jarsoftelectrical/PLUS/STL files/Pictures/20170216_212925.jpg

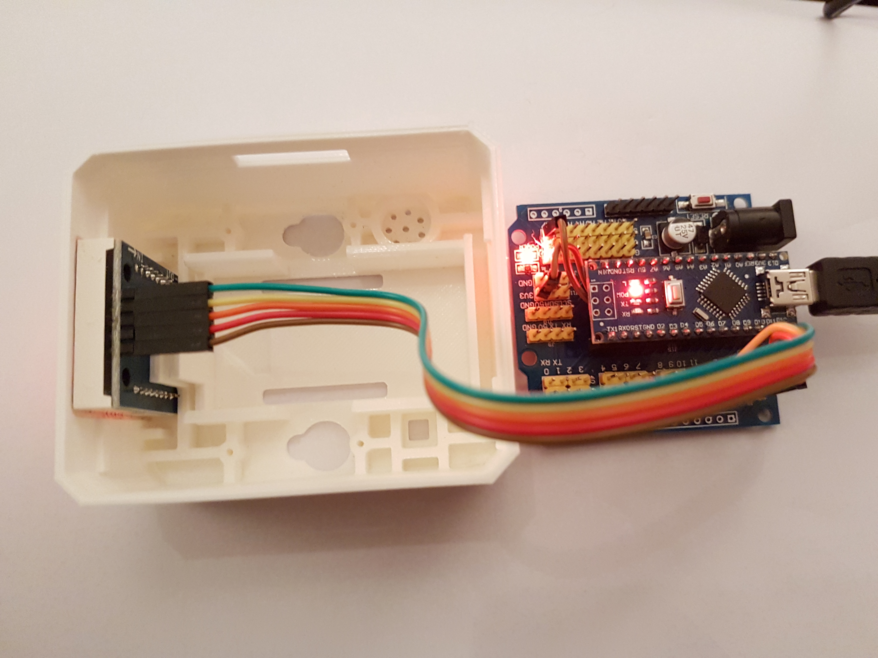
STL files/Pictures/20170216_212925.jpg
