jarsoftelectrical/PLUS/STL files/Pictures/20170216_213122.jpg

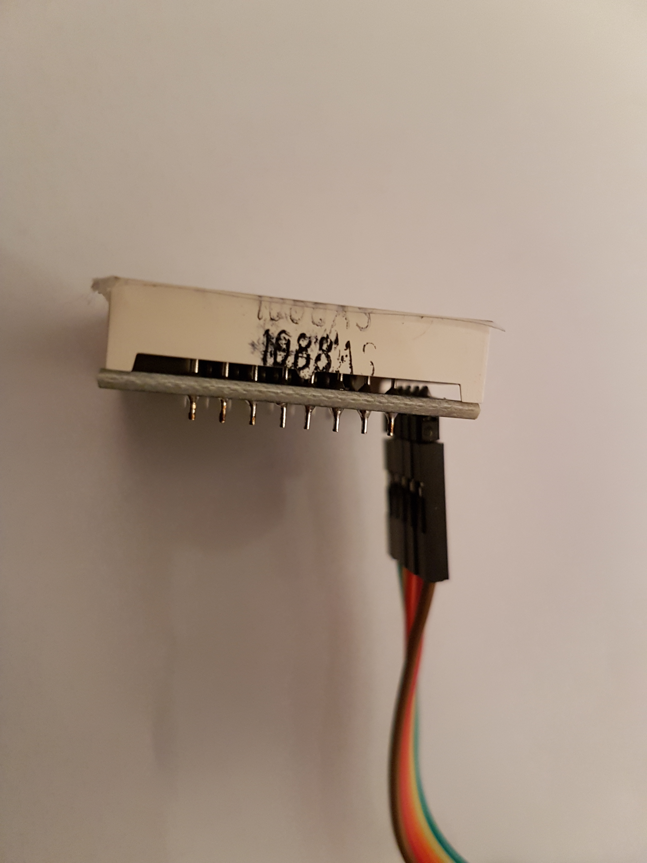
STL files/Pictures/20170216_213122.jpg
