jarsoftelectrical/PLUS/README.md

# PLUS
"Otto DIY with steroids" + Bluetooth + APP + switch + sensors + strength +...
