jarsoftelectrical/PLUS/OTTO-PCB/OTTO PCB ver2.png

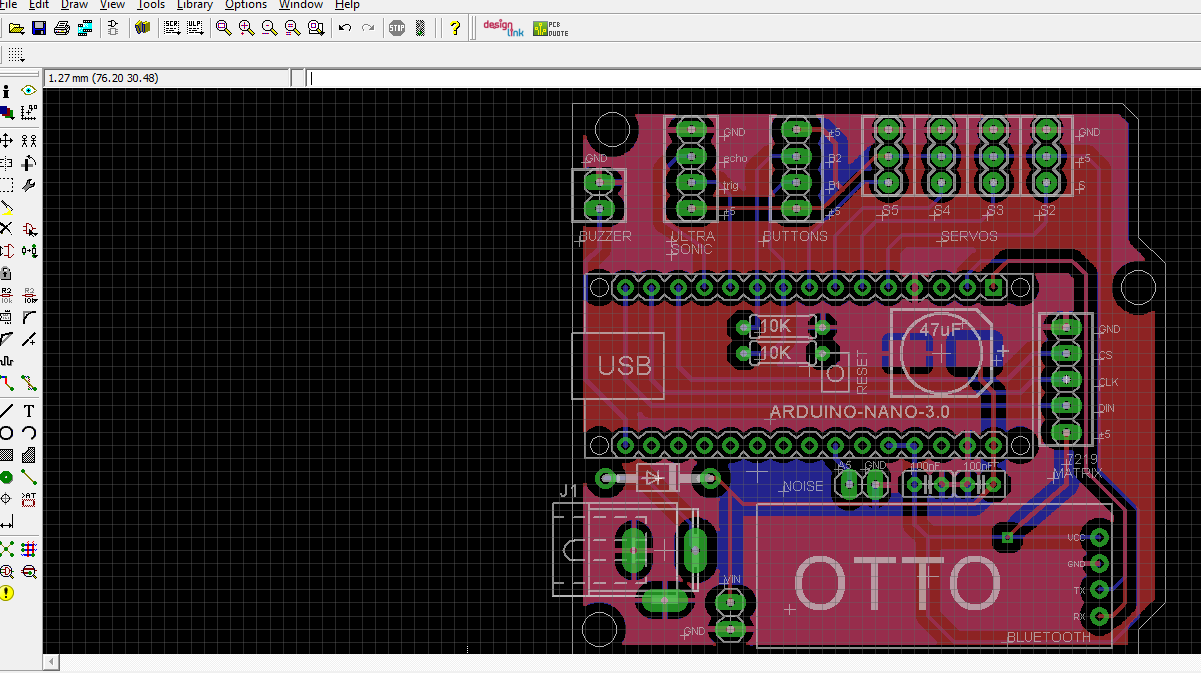
OTTO-PCB/OTTO PCB ver2.png
