jarsoftelectrical/PLUS/STL files/Pictures/20170216_222948.jpg

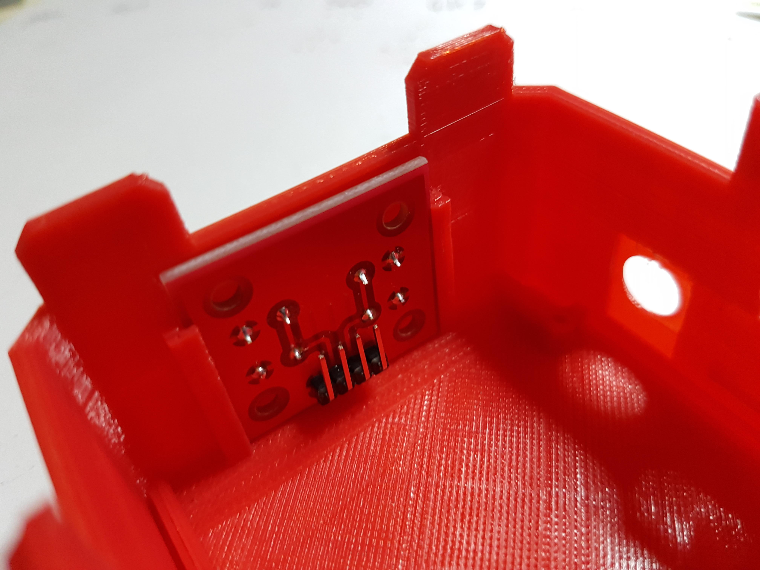
STL files/Pictures/20170216_222948.jpg
