jarsoftelectrical/PLUS/STL files/Pictures/20170217_212710.jpg

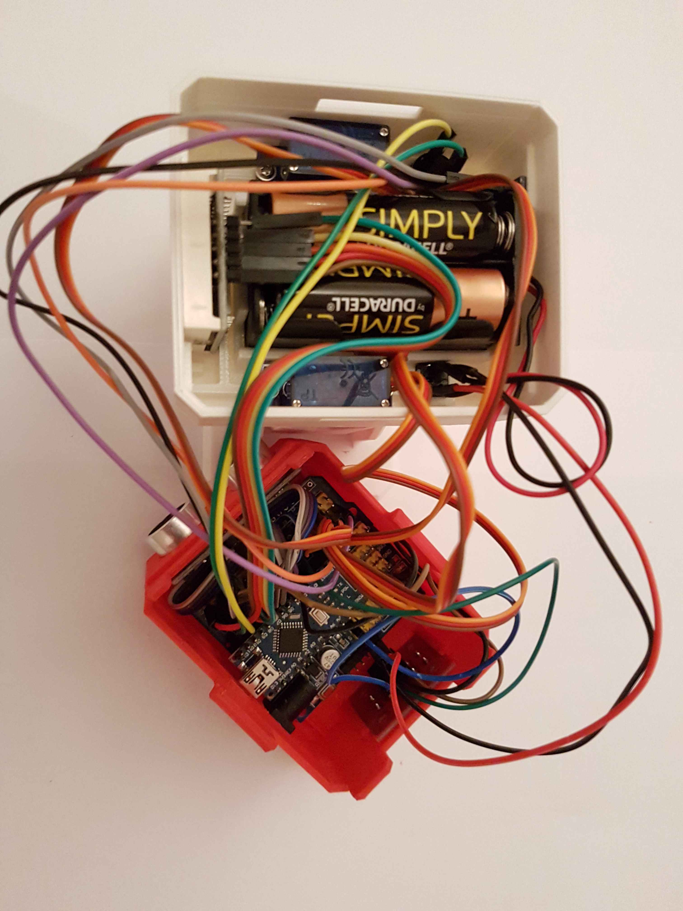
STL files/Pictures/20170217_212710.jpg
