jarsoftelectrical/PLUS/STL files/Pictures/20170217_213456.jpg

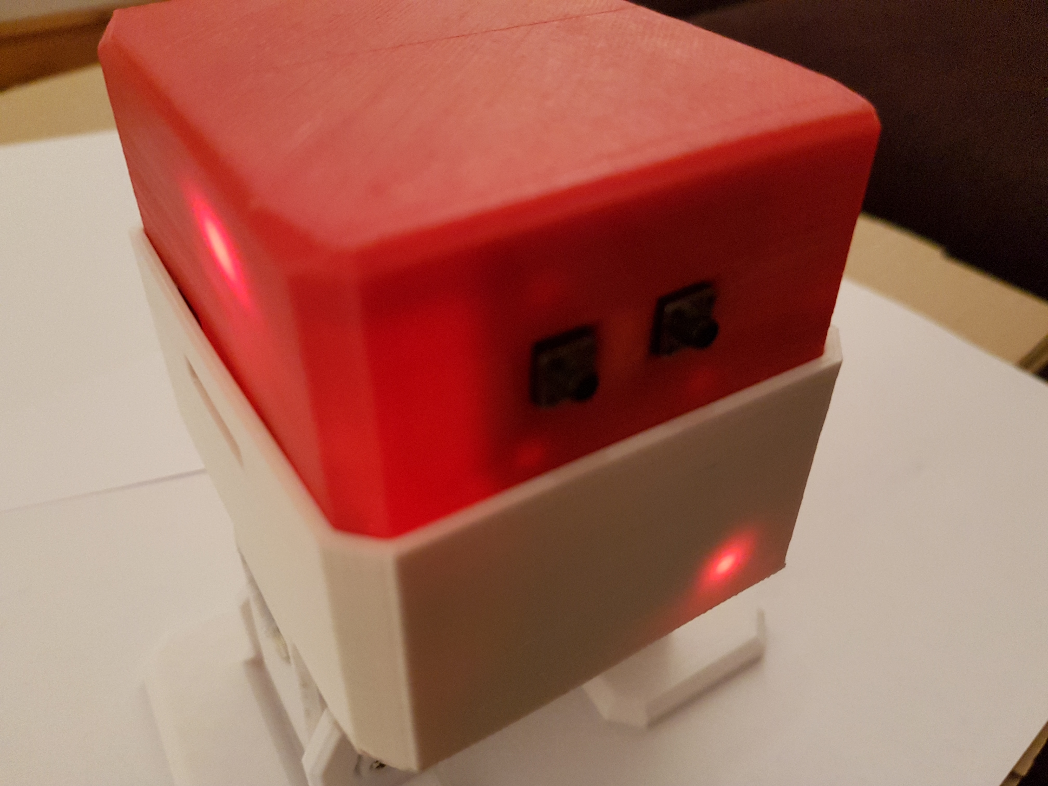
STL files/Pictures/20170217_213456.jpg
