jarsoftelectrical/PLUS/STL files/Head_MATRIX_5.stl

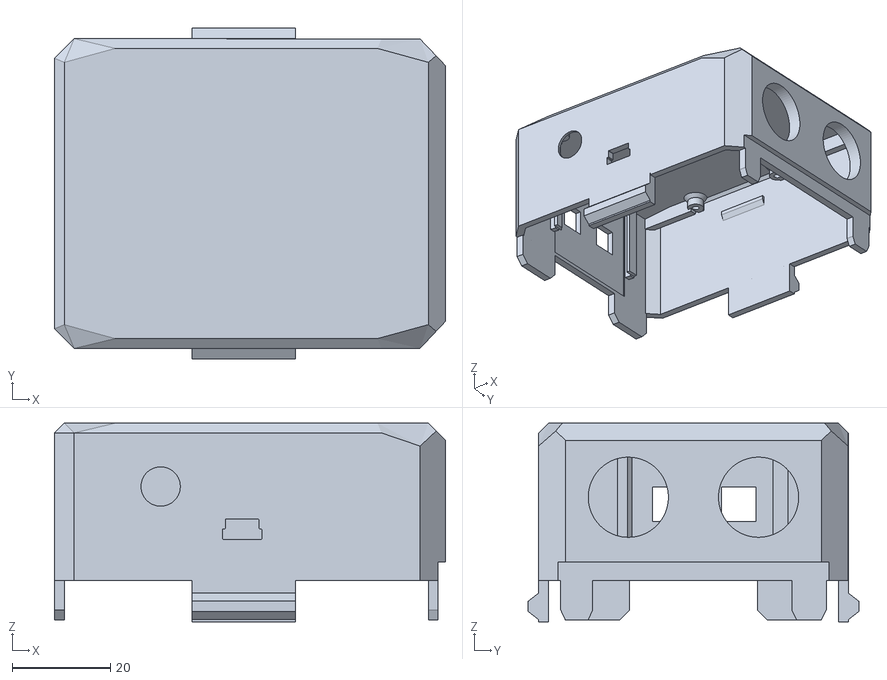
[picture p7: CAD file, 2017-02-22]
STL files/Head_MATRIX_5.stl
79.5 x 67.2 x 40.4
