jarsoftelectrical/PLUS/STL files/Body_MATRIX_4.stl

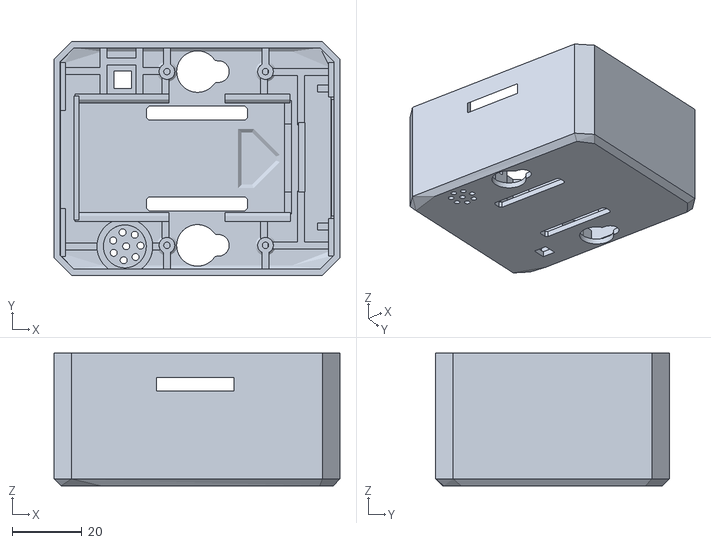
[picture p8: CAD file, 2017-02-22]
STL files/Body_MATRIX_4.stl
82.0 x 67.0 x 38.0
