jarsoftelectrical/PLUS/OTTO-PCB/otto.brd

## EAGLE design OTTO-PCB/otto.brd (2017-02-22)

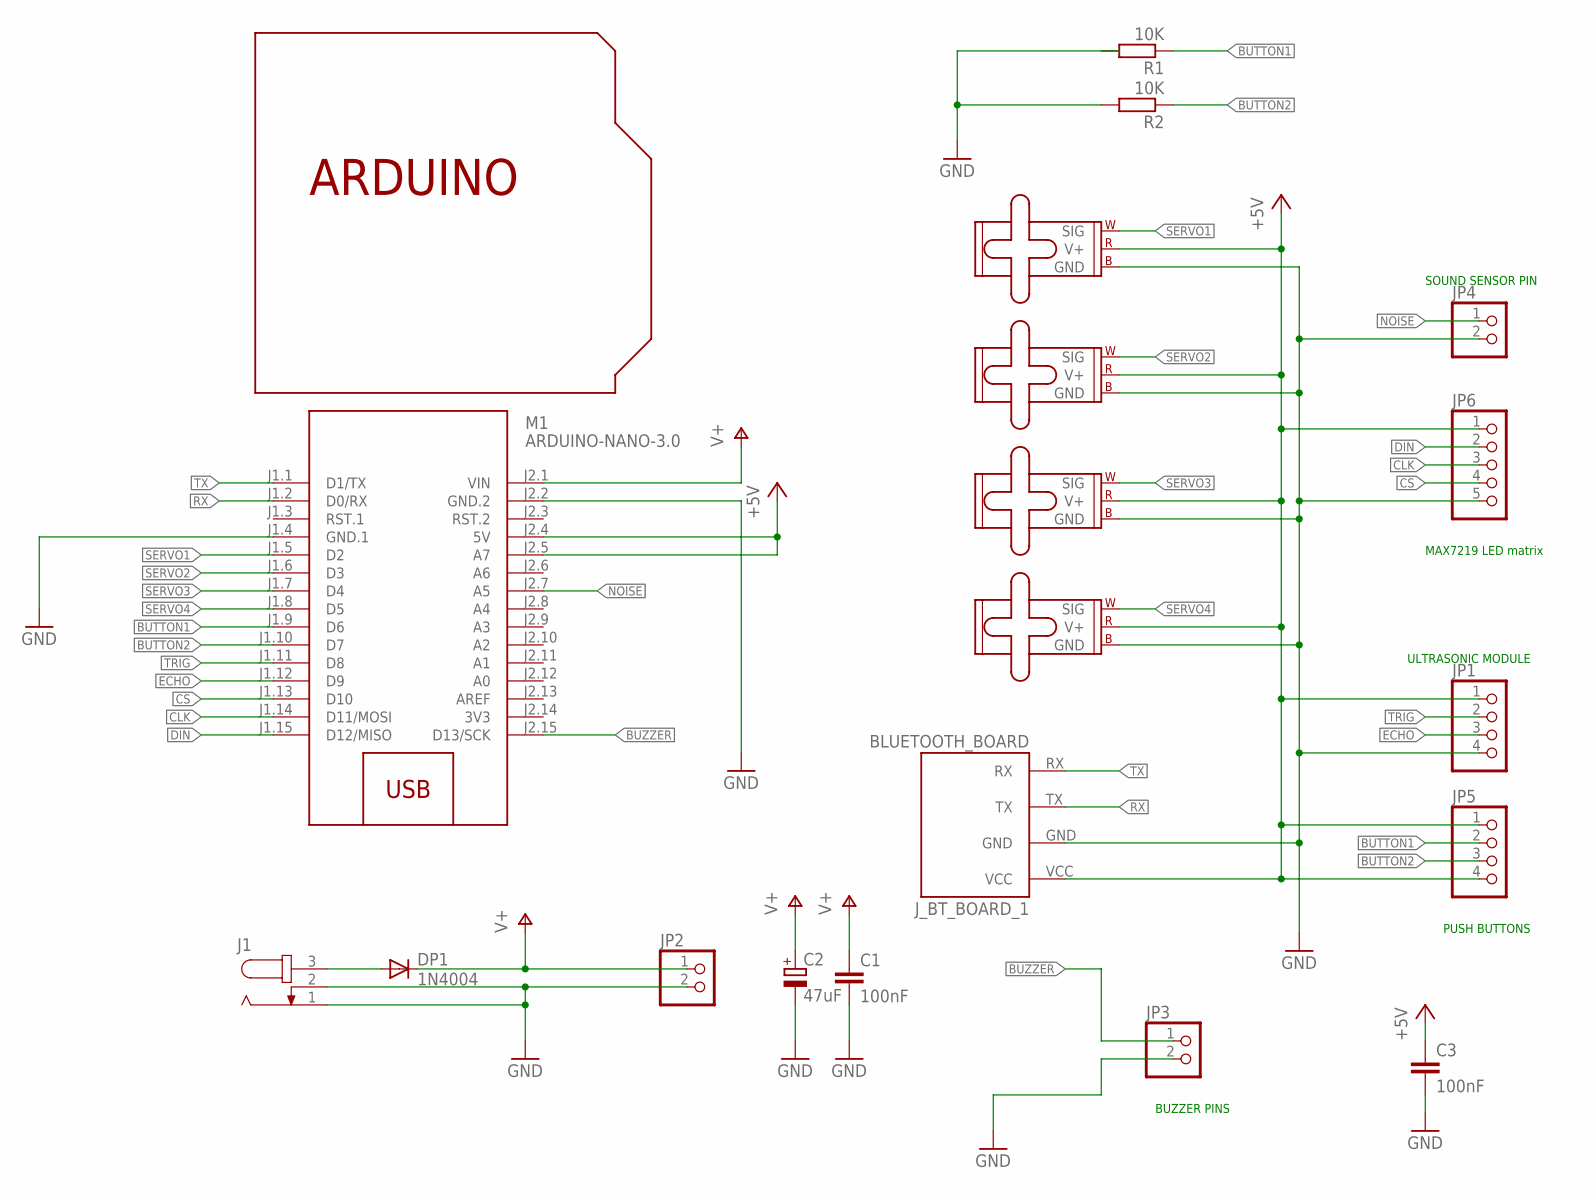
[picture p12: schematic otto.sch]

Parts:
C1, C3: 100nF; C025-025X050
C2: 47uF; 140CLH-0810
DP1: 1N4004; DO41-10
J1: JACK-PLUG0; SPC4077
JP1, JP5: PINHD-1X4; 1X04
JP2, JP3, JP4: PINHD-1X2; 1X02
JP6: PINHD-1X5; 1X05
J_BT_BOARD_1: BLUETOOTH_BOARD; BT_BOARD_FOOTPRINT
M1: ARDUINO-NANO-3.0
M2, M3, M4, M5: SMALL_SERVO; 1X03
R1, R2: 10K; 0207/7
U$1: SHIELDSMALL; ARDUINOSHIELDSMALL

Connections:
3V3: M1.J2.14 (3V3)
+5V: C3.1, JP1.1, JP5.1, JP5.4, JP6.1, J_BT_BOARD_1.VCC, M1.J2.4 (5V), M1.J2.5 (A7), M2.2 (V+), M3.2 (V+), M4.2 (V+), M5.2 (V+)
BUTTON1: JP5.2, M1.J1.9 (D6), R1.1
BUTTON2: JP5.3, M1.J1.10 (D7), R2.1
BUZZER: JP3.1, M1.J2.15 (D13/SCK)
CLK: JP6.3, M1.J1.14 (D11/MOSI)
CS: JP6.4, M1.J1.13 (D10)
DIN: JP6.2, M1.J1.15 (D12/MISO)
ECHO: JP1.3, M1.J1.12 (D9)
GND: C1.2, C2.-, C3.2, J1.1, J1.2, JP1.4, JP2.2, JP3.2, JP4.2, JP6.5, J_BT_BOARD_1.GND, M1.J1.4 (GND.1), M1.J2.2 (GND.2), M2.3 (GND), M3.3 (GND), M4.3 (GND), M5.3 (GND), R2.2
unnamed: DP1.A, J1.3
NOISE: JP4.1, M1.J2.7 (A5)
RX: J_BT_BOARD_1.TX, M1.J1.2 (D0/RX)
SERVO1: M1.J1.5 (D2), M2.1 (SIG)
SERVO2: M1.J1.6 (D3), M3.1 (SIG)
SERVO3: M1.J1.7 (D4), M4.1 (SIG)
SERVO4: M1.J1.8 (D5), M5.1 (SIG)
TRIG: JP1.2, M1.J1.11 (D8)
TX: J_BT_BOARD_1.RX, M1.J1.1 (D1/TX)
V+: C1.1, C2.+, DP1.C, JP2.1, M1.J2.1 (VIN)

Notes on the sheet:
MAX7219 LED matrix
ULTRASONIC MODULE
PUSH BUTTONS
SOUND SENSOR PIN
BUZZER PINS

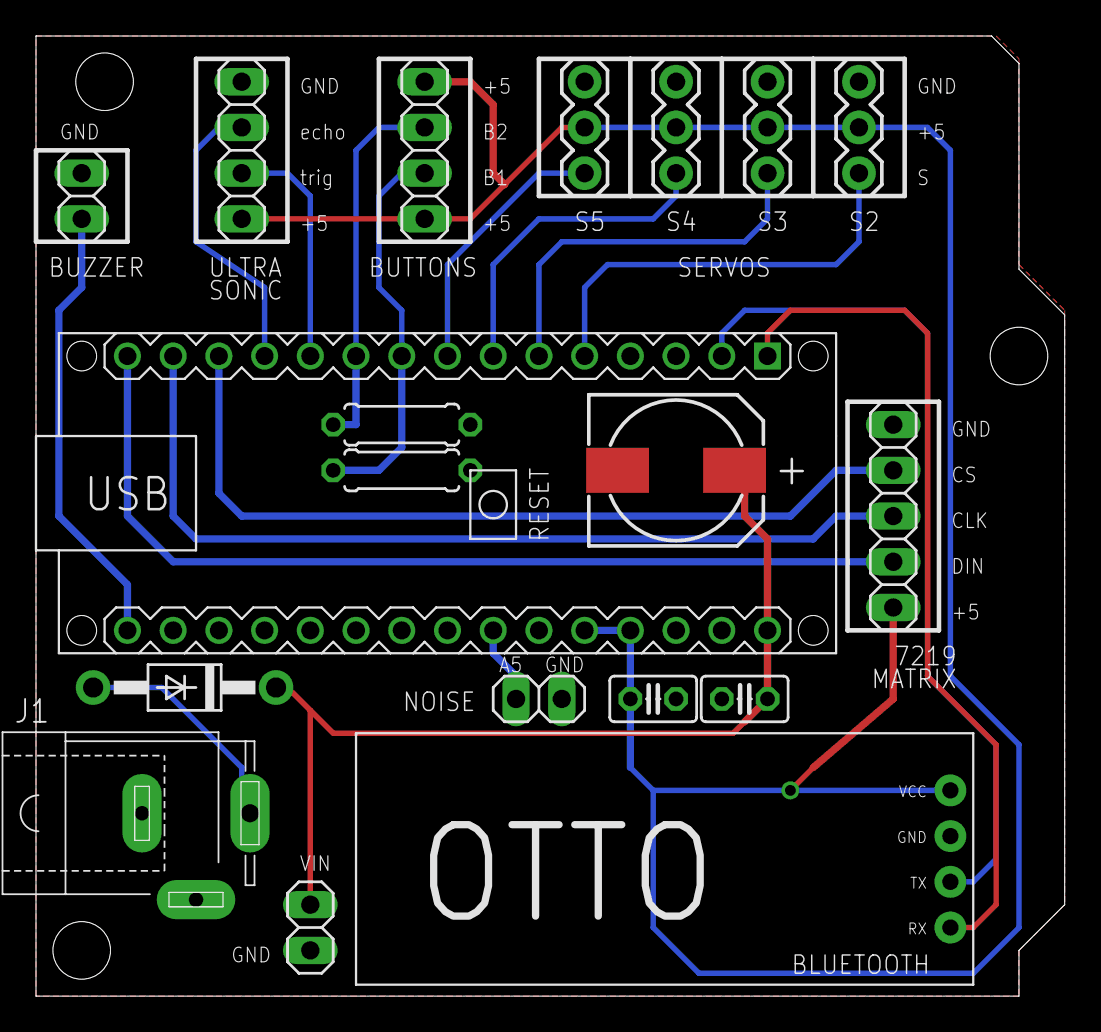
[picture p13: board otto.brd from above]

Board: 2 copper layers, 57.2 x 53.3 mm, 20 parts (0 on the bottom side), 19 nets.
